blackjetrock/psion-org2-top-slot/README.md

# psion-org2-top-slot
Psion Organiser 2 top slot interface

Top slot interface that can be attached to arbitrary hardware. RP2040 is used to present
a ROM with code that drives the hardware. The hardware is also interfaced using the datapak
code, using the extra states that drive hardware
