blackjetrock/psion-org2-top-slot/top_slot_breakout/fab1/top_slot_v1.0_errata.txt

Top Slot Breakout V1.0 Errata
=============================

1. OLED display connections reversed
2. IO7 not connected to Pico (break on schematic)
