blackjetrock/psion-org2-top-slot/(commit log)

2021-09-16 Added code based on (identical to) pak-gadget
    [pak_breakout-B_Cu.gbr, pak_breakout-B_Mask.gbr, pak_breakout-B_Paste.gbr, pak_breakout-B_SilkS.gbr, pak_breakout-Edge_Cuts.gbr, pak_breakout-F_Cu.gbr, pak_breakout-F_Mask.gbr, pak_breakout-F_Paste.gbr]
2021-09-17 First working code. Comms ROM adds entry to main menu
    [pak_breakout.sch]
2021-09-30 Code altered to support Pico port on top slot. This is done as per the technical manual using the states for RAM pack writing and 128K packs, which aren't supported on the top slot.
2021-10-11 Top slot changes
